Bartyzel88/insulintemp/(commit log)

2026-08-13 Update print statement from 'Hello' to 'Goodbye'
2026-08-13 Revise power consumption and range testing sections
    Updated sections on power consumption measurement and range testing in the README. Added details on current draw implications and LED signaling behavior.
